Neelabh1929/GestureSense/Docs/ep2.jpeg

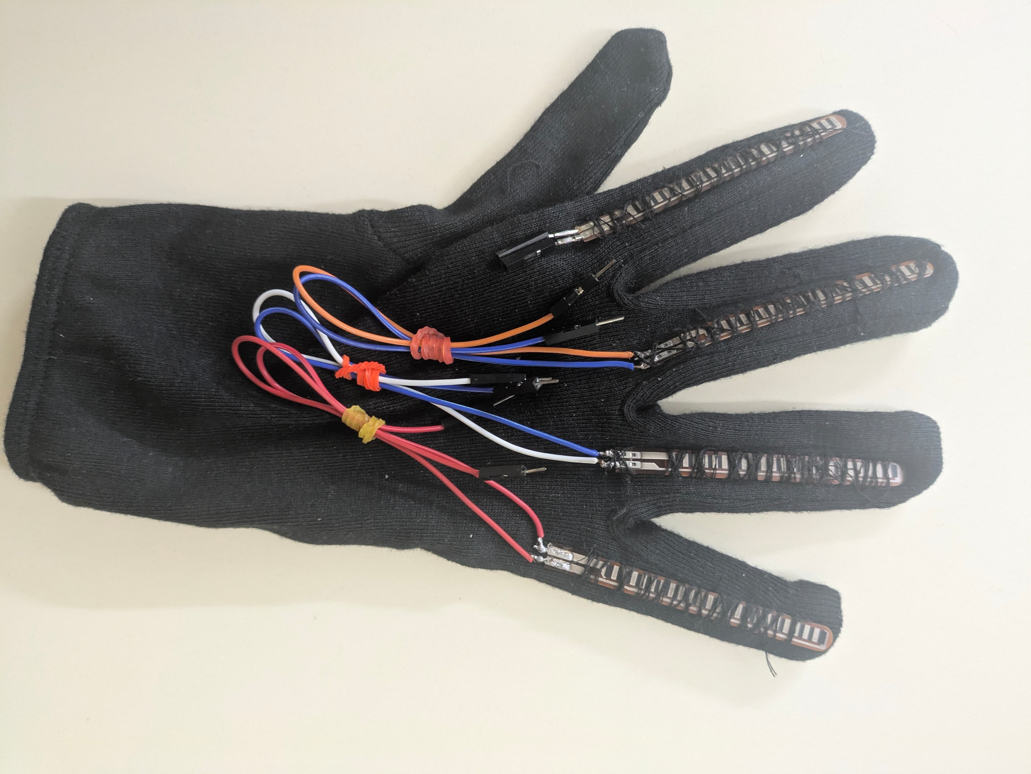
Docs/ep2.jpeg
