Neelabh1929/GestureSense/Docs/Glove_image.jpeg

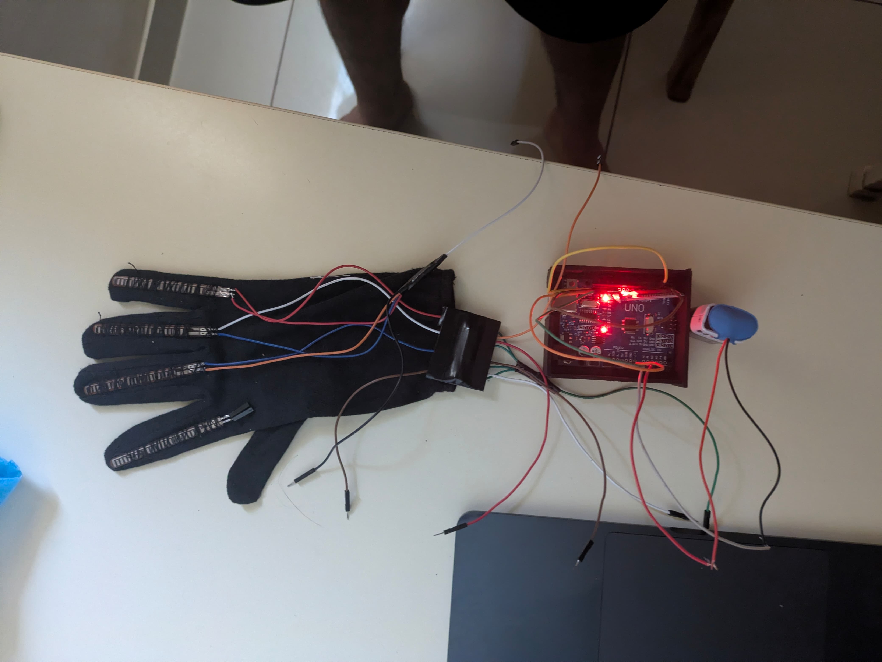
Docs/Glove_image.jpeg
