Neelabh1929/GestureSense/src/Circuit.png

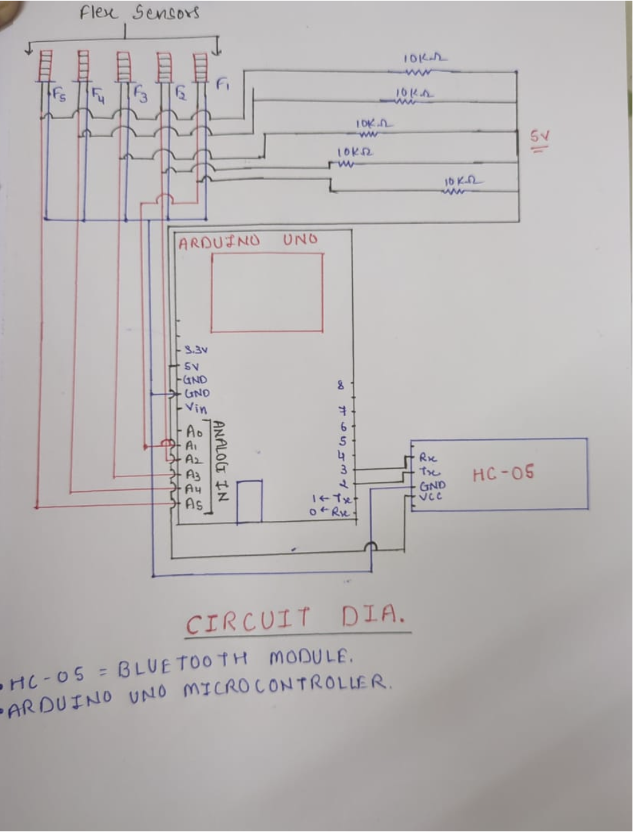
src/Circuit.png
